fthouin/lineLevelConv/levelConversionOpAmp/levelConversionOpAmp.kicad_pcb

## KiCad design levelConversionOpAmp/levelConversionOpAmp.kicad_pcb (2023-06-17)

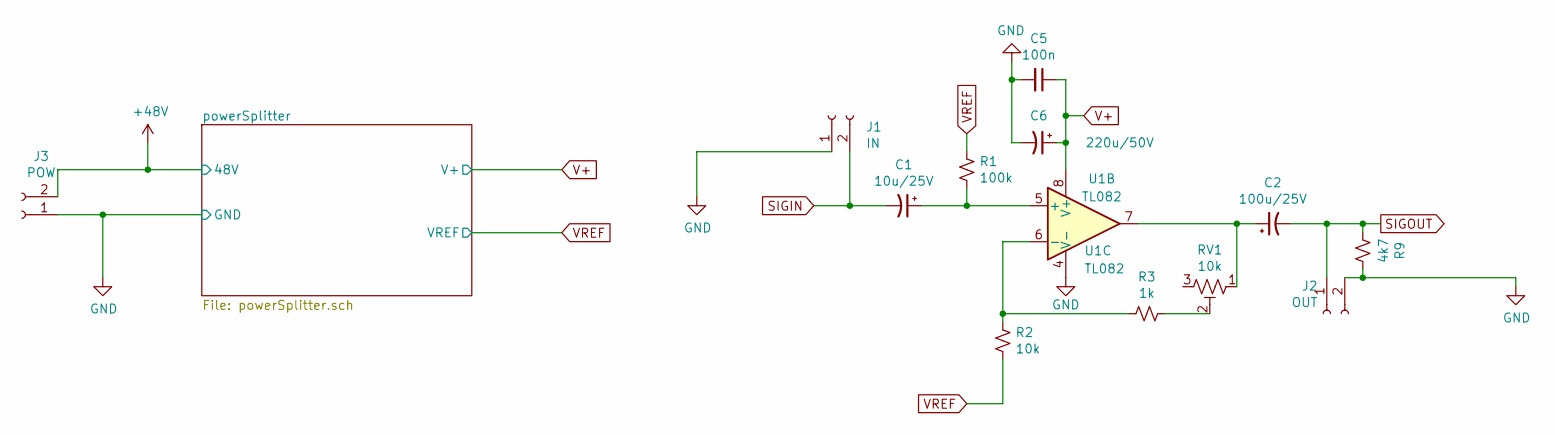
[picture p3: schematic levelConversionOpAmp.sch, Convertisseur de niveau de ligne]

Parts:
C1: 10u/25V; CP_Radial_D7.5mm_P2.50mm
C2: 100u/25V; CP_Radial_D7.5mm_P2.50mm
C5: 100n; C_Disc_D12.5mm_W5.0mm_P7.50mm
C6: 220u/50V; CP_Radial_D7.5mm_P2.50mm
J1: IN; TerminalBlock_Altech_AK300-2_P5.00mm
J2: OUT; TerminalBlock_Altech_AK300-2_P5.00mm
J3: POW; TerminalBlock_Altech_AK300-2_P5.00mm
R1: 100k; R_Axial_DIN0207_L6.3mm_D2.5mm_P7.62mm_Horizontal
R2: 10k; R_Axial_DIN0207_L6.3mm_D2.5mm_P7.62mm_Horizontal
R3: 1k; R_Axial_DIN0207_L6.3mm_D2.5mm_P7.62mm_Horizontal
R9: 4k7; R_Axial_DIN0207_L6.3mm_D2.5mm_P7.62mm_Horizontal
RV1: 10k; Potentiometer_ACP_CA14-H2,5_Horizontal
U1: TL082

Connections:
+48V: J3.2; also elsewhere on the board
GND: C5.2, C6.2, J1.1, J2.2, J3.1, R9.1, U1.4 (V-); also elsewhere on the board
unnamed: C1.1, R1.2, U1.5 (+)
unnamed: C2.1, RV1.1, U1.7
unnamed: R2.1, R3.2, U1.6 (-)
unnamed: R3.1, RV1.2
SIGIN: C1.2, J1.2
SIGOUT: C2.2, J2.1, R9.2
V+: C5.1, C6.1, U1.8 (V+); also elsewhere on the board
VREF: R1.1, R2.2; also elsewhere on the board

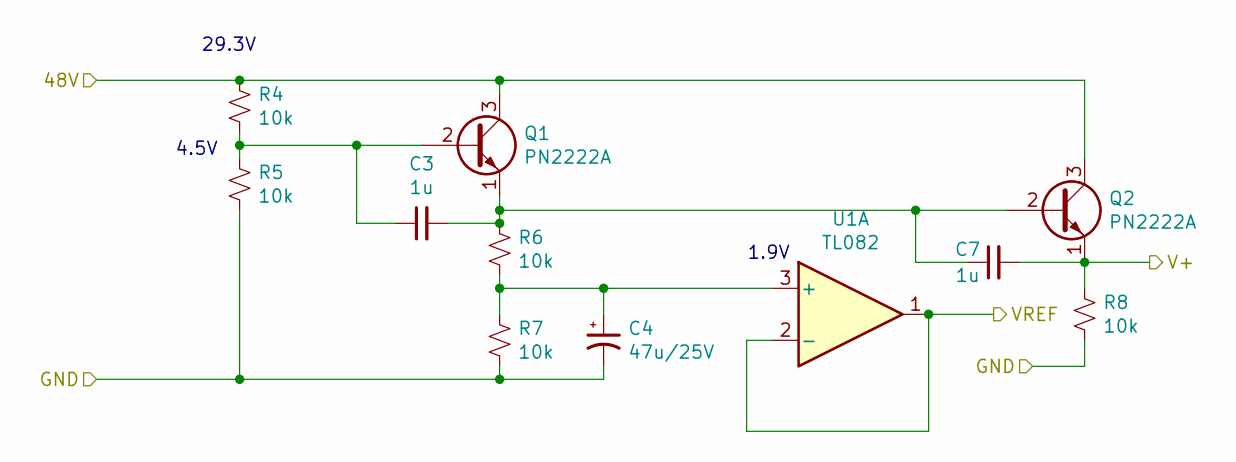
[picture p4: schematic powerSplitter.sch, Source d'alimentation et de VREF]

Parts:
C3, C7: 1u; C_Disc_D12.5mm_W5.0mm_P7.50mm
C4: 47u/25V; CP_Radial_D7.5mm_P2.50mm
Q1, Q2: PN2222A; TO-92_Inline_Wide
R4, R5, R6, R7, R8: 10k; R_Axial_DIN0207_L6.3mm_D2.5mm_P7.62mm_Horizontal
U1: TL082; DIP-8_W7.62mm

Connections:
+48V: Q1.3 (C), Q2.3 (C), R4.1; also elsewhere on the board
GND: C4.2, R5.2, R7.2, R8.2; also elsewhere on the board
unnamed: C3.1, Q1.2 (B), R4.2, R5.1
unnamed: C3.2, C7.1, Q1.1 (E), Q2.2 (B), R6.1
unnamed: C4.1, R6.2, R7.1, U1.3 (+)
V+: C7.2, Q2.1 (E), R8.1; also elsewhere on the board
VREF: U1.1, U1.2 (-); also elsewhere on the board

Notes on the sheet:
1.9V
4.5V
29.3V

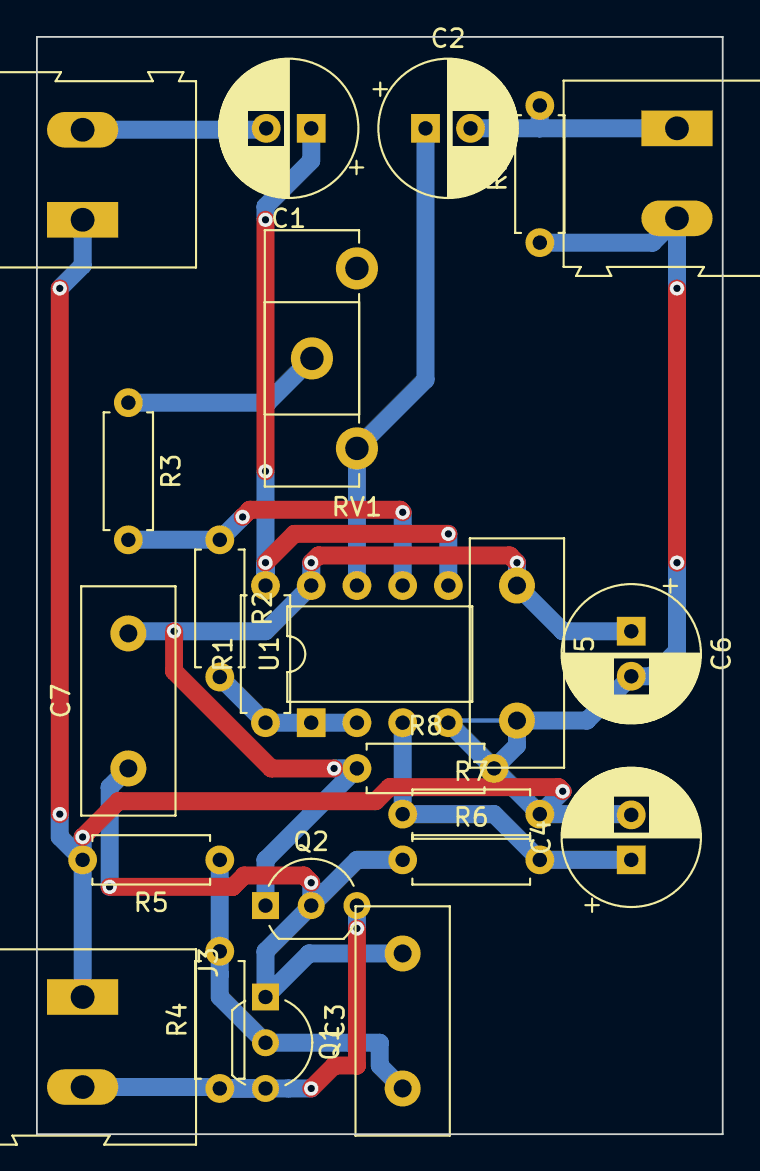
[picture p5: board levelConversionOpAmp.kicad_pcb from above]

Board: 2 copper layers, 38.1 x 61.0 mm, 23 parts (0 on the bottom side), 13 nets.
