fthouin/lineLevelConv/Tests/thd.png

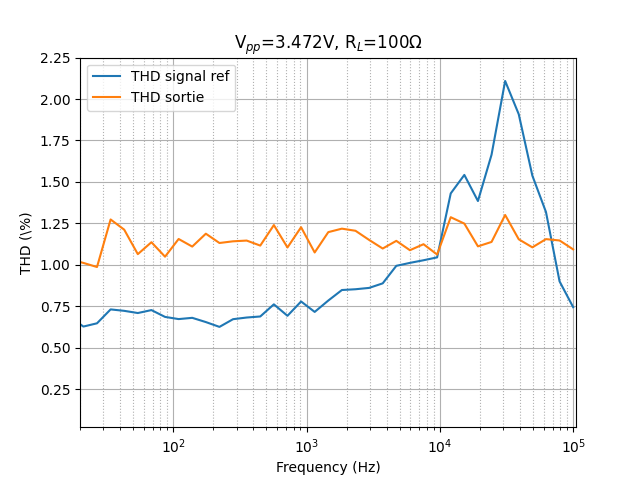
Tests/thd.png
