fthouin/lineLevelConv/Tests/transFunc.png

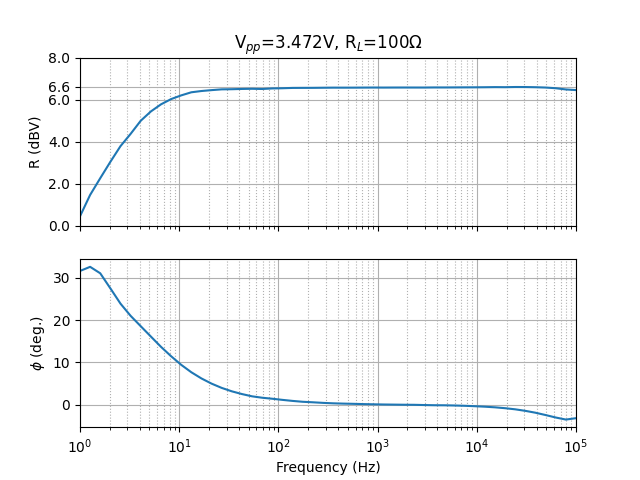
Tests/transFunc.png
