fthouin/lineLevelConv/(commit log)

2023-05-12 Rev. A. Schema et tests sur breadboard
    [levelConversionOpAmp.kicad_pcb, levelConversionOpAmp.sch, powerSplitter.sch]
2023-06-08 Placement des composantes sur plaque perforee
    [levelConversionOpAmp.kicad_pcb, levelConversionOpAmp.sch, powerSplitter.sch]
2023-06-17 Changed layout a little. Added ground bias resistor at output to quickly set output DC level even when plugged into a high impedance load
    [levelConversionOpAmp.kicad_pcb, levelConversionOpAmp.sch, powerSplitter.sch]
